uob-hep-cad/uob-hep-pc069/README.md

# uob-hep-pc069
DUNE Timing System Reference Hardware FMC. 

Successor to pc053a,c,d,e ( https://webapps-pp.bris.ac.uk/svn/uob-hep-pc053a/ )

Circuit schematic at https://github.com/uob-hep-cad/uob-hep-pc069/blob/main/hardware/Schematics/pc069a_toplevel.pdf

(N.B. Unlike pc053 , this design has no ADN2814 CDR )

List of changes w.r.t. pc053e at https://uob-my.sharepoint.com/:x:/g/personal/phdgc_bristol_ac_uk/Eb3lEkg4T_dNv52CUFCi3MEB-VoL37d42aNxBQbhaa6lCw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 (sorry, UoB only :-( )

Top level IPBus-Build (ipbb) dependency file for a design to act as a timing master when used in conjunction with a Digilent Nexys Video FPGA board can be found at https://gitlab.cern.ch/dune-daq/timing/dune-timing-firmware/-/blob/develop/projects/master/firmware/cfg/top_digilent_nexys_video_a200_pc069a.dep

Ready-built FPGA configuration file at https://pdts-fw.web.cern.ch/pdts-fw/index.php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

Can use dtsbutler to control master design. 

See https://github.com/DUNE-DAQ/timing/wiki/Dune-Timing-System-Page-1 


*Top view of pc069a*


*Bottom view of pc069a*

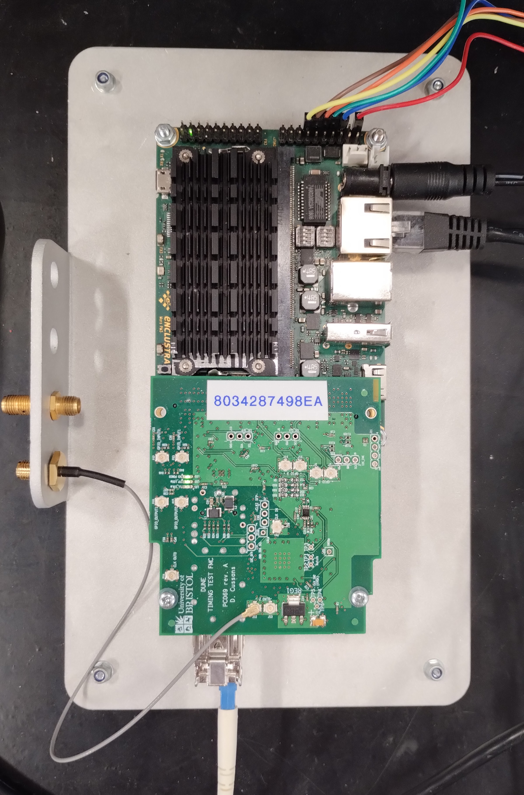
[picture p1: images/pc069a_on_pm3_IMG_20240729_135957526.jpg]

*pc069a mounted on Enclustra PM3/AX3 FPGA board*
