uob-hep-cad/uob-hep-pc069/hardware/Manufacturing/artwork/pc069c_25-manufacturing-artwork-2025-02-06/pc069c_summary_bom_mouser.xlsx

TITLE: Bill of Materials
DATE: 01/31/2025
DESIGN: pc069c_toplevel
TEMPLATE: Z:\cad\tools\cadence_templates\spreadsheet-format.bom
CALLOUT:
Part Name | Ref Des | Qty | PART_NUMBER | Do Not Fit | Mouser Part Number | Mfr Part Number | Manufacturer Name | Description
24AA025E48T-I/SN | IC2 | 1 | 24AA025E48T-I/SN | ? | 579-24AA025E48T-I/SN | 24AA025E48T-I/SN | Microchip
74LCX04MTC | IC9 | 1 | 74LCX04MTC | ? | 512-74LCX04MTC | 74LCX04MTC | onsemi | Inverters Inverters Hex Inverter
ADCMP604BKSZ | IC6,IC7 | 2 | ADCMP604BKSZ | ? | 584-ADCMP604BKSZR7 | ADCMP604BKSZ-REEL7 | Analog Devices Inc. | Analog Comparators Analog Comparators Rail to rail,sing chan, TTL/CMOS Compara
Capacitor, SMD, 0402 , 1.0NF,50V | C30,C34,C37,C41 | 4 | Capacitor , SMD , 0402_1NF_50V_10% | ? |  |  | Newbury Electronics
Capacitor, SMD, 0402 , 100NF,16V | C1,C2,C3,C4,C5,C6,C7,C8,C9,C10,C11,C13,C14,C15,C16,C17,C18,C19,C20,C21,C22,C23,C24,C25,C26,C27,C28,C29,C31,C32,C33,C36,C38,C39,C40,C42,C43,C44,C45,C46,C47,C48,C49,C50,C52,C53,C55,C56,C57,C58,C59,C60,C61,C62,C63,C69,C70,C71,C72,C107,C117 | 61 | Capacitor , SMD , 0402_100NF_16V_10% | ? |  |  | Newbury Electronics
Capacitor, SMD, 0805 , 10UF,16V | C35,C51,C54,C64,C65,C66 | 6 | Capacitor , SMD , 0805_10UF_16V_10% | ? |  |  | Newbury Electronics
CON20P_SFP-1888247-1 | J4 | 1 | 1888247-1 | ? | 571-1888247-1 | 1888247-1 | TE Connectivity | I/O Connectors I/O Connectors 20 POS SMT 30um GOLD HIGH SPEED
CON3P-MTLW-103-07-L-S-250 | J3,J5,J6,J8,J10 | 5 | MTLW-103-07-L-S-250 | TRUE | 200-MTLW10307LS250 | MTLW-103-07-L-S-250 | Samtec | Headers & Wire Housings Headers & Wire Housings .100" Low Profile Variable Post Height Terminal Strip
CON400P_40ABCDEFGHJK-SEAM-40-03.5-S-10-2-A-K-TR | P1 | 1 | SEAM-40-03.5-S-10-2-A-K-TR | ? | 200-SEAM4003.5S102AK | SEAM-40-03.5-S-10-2-A-K-TR | Samtec | Board to Board & Mezzanine Connectors Board to Board & Mezzanine Connectors .050" SEARAY High-Speed High-Density Open-Pin-Field Array Terminal
CON4P-MTLW-104-07-L-S-250 | J11 | 1 | MTLW-104-07-L-S-250 | TRUE | 200-MTLW10407LS250 | MTLW-104-07-L-S-250 | Samtec | Headers & Wire Housings Headers & Wire Housings .100" Low Profile Variable Post Height Terminal Strip
DS90LV028A_SOIC | IC8 | 1 | DS90LV028ATM | ? | 926-DS90LV028ATMNOPB | DS90LV028ATM/NOPB | Texas Instruments | LVDS Interface IC 3V LVDS DUAL CMOS DIFF LINE RECEIVER
ELCAPTAN_SMD-22UF,10V | C12 | 1 | T491A226K010A | ? | 80-T491A226K010AH | T491A226K010AH | KEMET | Tantalum Capacitors - Solid SMD Tantalum Capacitors - Solid SMD 10v 22uF 1206 10% ESR=6ohms
INDUCTANCE_LQH32C_23-4.7UH | L1,L2 | 2 | LQH32CN4R7M23 | ? | 81-LQH32CN4R7M23L | LQH32CN4R7M23L | Murata | RF Inductors - SMD RF Inductors - SMD 4.7 UH 20%
LD3985M25R | RG1,RG2 | 2 | LD3985M25R | ? | 511-LD3985M25R | LD3985M25R | STMicroelectronics | LDO Voltage Regulators LDO Voltage Regulators 2.5V 0.15A Ultra Low
LGL29K-G2J1-24 | LD1,LD2,LD3 | 3 | LGL29K-G2J1-24 | ? | 720-LGL29KG2J124Z | LG L29K-G2J1-24 | ams OSRAM | Single Color LEDs Single Color LEDs Green, 570nm 12mcd, 2mA
LM1117-MPX-1.8 | REG1 | 1 | LM1117MPX-1.8 | ? | 926-LM1117MPX-18 | LM1117MPX-1.8 | Texas Instruments | LDO Voltage Regulators LDO Voltage Regulators
MAX9381ESA_SMD-MAX9381ESA | U1 | 1 | MAX9381ESA | ? | 700-MAX9381ESA | MAX9381ESA+ | Analog Devices Inc. | Flip Flops Flip Flops Lowest Power 3.0GHz ECL/PECL Differentia
PCOAX-U.FL-R-SMT-1(10) | J2,J7,J12,J13,J14,J15,PX1,PX2,PX3,PX4,PX5,PX6 | 12 | U.FL-R-SMT-1(10) | ? | 798-U.FL-R-SMT-110 | U.FL-R-SMT-1(10) | Hirose Electric | RF Connectors / Coaxial Connectors RF Connectors / Coaxial Connectors SMT ML REC AU 50 OHM W/ANTI SLDR WCKNG R
Resistor, SMD, 0402 , 0.0625W-XX,1% | R9,R14,R32,R33,R41,R60,R140,R411 | 8 | Resistor , SMD , 0402_XX_1%_0.063W | TRUE | ? | ? | Newbury Electronics | ? | GENERIC | ?
Resistor, SMD, 0402 0R0,1% | R44,R58,R59 | 3 | Resistor , SMD , 0402_00R | ? | ? | ? | Newbury Electronics | ? | GENERIC | ?
Resistor, SMD, 0402 100,1% | R7,R8,R11,R18,R45,R46 | 6 | Resistor , SMD , 0402_100R | ? | ? | ? | Newbury Electronics | ? | GENERIC | ?
Resistor, SMD, 0402 150,1% | R5,R6 | 2 | Resistor , SMD , 0402_150R | ? | ? | ? | Newbury Electronics | ? | GENERIC | ?
Resistor, SMD, 0402 1K,1% | R10,R17,R19,R20,R21 | 5 | Resistor , SMD , 0402_1K | ? | ? | ? | Newbury Electronics | ? | GENERIC | ?
Resistor, SMD, 0402 2K,1% | R36,R38 | 2 | Resistor , SMD , 0402_2K | ? | ? | ? | Newbury Electronics | ? | GENERIC | ?
Resistor, SMD, 0402 3.0K,1% | R35,R37 | 2 | Resistor , SMD , 0402_3K0 | ? | ? | ? | Newbury Electronics | ? | GENERIC | ?
Resistor, SMD, 0402 4.7K,1% | R1,R13,R16,R22,R23,R24,R25,R28,R29,R39,R42,R43,R61,R103,R138,R142,R143,R242,R1328 | 19 | Resistor , SMD , 0402_4K7 | ? | ? | ? | Newbury Electronics | ? | GENERIC | ?
Resistor, SMD, 0402 750,1% | R50,R51,R56 | 3 | Resistor , SMD , 0402_750R | ? | ? | ? | Newbury Electronics | ? | GENERIC | ?
Resistor, SMD, 0603 , 1.2K,1% | R12,R52,R54,R57 | 4 | Resistor , SMD , 0603_1K2 | ? | ? | ? | Newbury Electronics | ? | GENERIC | ?
Resistor, SMD, 0603 , 100,1% | R2,R3,R15,R26,R30,R31,R40,R62 | 8 | Resistor , SMD , 0603_100R | ? | ? | ? | Newbury Electronics | ? | GENERIC | ?
Resistor, SMD, 0603 , 33,1% | R27,R47,R48,R49 | 4 | Resistor , SMD , 0603_33R | ? | ? | ? | Newbury Electronics | ? | GENERIC | ?
Resistor, SMD, 0603 , 820,1% | R4,R34,R53,R55 | 4 | Resistor , SMD , 0603_820R | ? | ? | ? | Newbury Electronics | ? | GENERIC | ?
SFP_CAGE-SP-74737-004 | SFP1 | 1 | 74737-004 | ? | 538-74737-0041 | 74737-0041 | Molex | I/O Connectors I/O Connectors SFP 1x Cage PressFit 3.05 Legs SS 301
SI5395A-A-GM | IC3 | 1 | SI5395A-A-GM | ? | 634-SI5395A-A-GM | SI5395A-A-GM | Skyworks | Clock Synthesizer / Jitter Cleaner Clock Synthesizer / Jitter Cleaner Single PLL jitter attenuator with ext crystal: 12-outputs up to 1028 MHz; integer+fractional
SIT5021AI-2DE-25E-50.000000 | QZ1 | 1 | SIT5021AI-2DE-25E-50.000000X | ? | 788-1AI-2DE-5E-50X | SIT5021AI-2DE-25E-50.000000X | SiTime | TCXO Oscillators TCXO Oscillators 50MHz 2.5V 5ppm -40C +85C
SN74AVC4T245PW | IC10 | 1 | SN74AVC4T245PW | ? | 595-SN74AVC4T245PW | SN74AVC4T245PW | Texas Instruments | Translation - Voltage Levels Translation - Voltage Levels 4-Bit Dual-Supply Bu s Xcvr A 595-SN74AVC4T245PWT
SN74LVC2GU04DCK | IC18 | 1 | SN74LVC2GU04DCK | ? | 595-SN74LVC2GU04DCKR | SN74LVC2GU04DCKR | Texas Instruments | Inverters Inverters Dual. A 595-SN74LVC2GU04DCKT
SY58608UMG | IC4 | 1 | SY58608UMG | ? | 998-SY58608UMG | SY58608UMG | Microchip | Encoders, Decoders, Multiplexers & Demultiplexers Encoders, Decoders, Multiplexers & Demultiplexers 4.25Gbps 2:1 LVPECL Multiplexer w/ FSI Inputs
TCA9800DGK | IC1,IC15 | 2 | TCA9800DGK | ? | 595-TCA9800DGKR | TCA9800DGKR | Texas Instruments | Interface - Signal Buffers, Repeaters Interface - Signal Buffers, Repeaters 2-bit level-translat ing 400-kHz I2C/SMBu A 595-TCA9800DGKT
TMP1075NDRLR-TEXAS INSTRUMENTS,TMP1075NDRLR | IC11 | 1 | TMP1075NDRLR | ? | 595-TMP1075NDRLR | TMP1075NDRLR | Texas Instruments
TP_HOLE-0.5MM | TP1,TP2,TP3,TP4,TP5,TP6 | 6 | TP_HOLE_0.5mm | TRUE
TP_HOLE-0.8MM | TP9,TP10 | 2 | TP_HOLE_0.8mm | TRUE
TOTAL |  | 193
