uob-hep-cad/uob-hep-pc069/hardware/Manufacturing/artwork/pc069b-manufacturing-artwork-2023-08-23/pc069b_summary_bom.xlsx

TITLE: Bill of Materials
DATE: 08/22/2023
DESIGN: pc069b_toplevel
TEMPLATE: /projects/HEP_Instrumentation/cad/tools/cadence_templates/spreadsheet-format.bom
CALLOUT:
Part Name | Ref Des | Quantity | Manufacturer PART NUMBER | Supplier | Do Not Fit | MANUFACTURER | DNF
24AA025E48T-I/SN | IC2 | 1 | 24AA025E48T-I/SN | FREE-ISSUE | ? | MICROCHIP | ?
74LCX04MTC | IC9 | 1 | 74LCX04MTC |  | ? | FAIRCHILD SEMICONDUCTOR | ?
ADCMP604BKSZ | IC6,IC7 | 2 | ADCMP604BKSZ |  | ? | ANALOG DEVICES | ?
CAPCERSMDCL2_0402-1.0NF,50V_GEN | C30,C34,C37,C41 | 4 | CC0402_1NF_50V_10%_X7R |  | ? | GENERIC | ?
CAPCERSMDCL2_0402-100NF,16V_GEN | C1,C2,C3,C4,C5,C6,C7,C8,C9,C10,C11,C13,C14,C15,C16,C17,C18,C19,C20,C21,C22,C23,C24,C25,C26,C27,C28,C29,C31,C32,C33,C36,C38,C39,C40,C45,C46,C47,C48,C49,C52,C53,C55,C56,C57,C58,C59,C60,C61,C62,C63,C69,C70,C71,C72,C107,C117 | 57 | CC0402_100NF_16V_10%_X7R |  | ? | GENERIC | ?
CAPCERSMDCL2_0603-100NF,16V | C42 | 1 | CC0603_100NF_16V_10%_X7R |  | ? | GENERIC | ?
CAPCERSMDCL2_0603-10UF_X5R,6.3V | C64 | 1 | CC0603_10UF_6V3_10%_X5R |  | ? | GENERIC | ?
CAPCERSMDCL2_0805-10UF,16V | C35 | 1 | C0805C106K4PAC |  | ? | KEMET | ?
CON20P_SFP-1888247-1 | J4 | 1 | 1888247-1 |  | ? | TYCO | ?
CON3P-MTLW-103-07-L-S-250 | J3,J5,J6,J8,J10 | 5 | MTLW-103-07-L-S-250 |  | TRUE | SAMTEC | ?
CON400P_40ABCDEFGHJK-SEAM-40-03.5-S-10-2-A-K-TR | P1 | 1 | SEAM-40-03.5-S-10-2-A-K-TR |  | ? | SAMTEC | ?
CON4P-MTLW-104-07-L-S-250 | J11 | 1 | MTLW-104-07-L-S-250 |  | TRUE | SAMTEC | ?
DS90LV028A_SOIC | IC8 | 1 | 08.DS90LV028ATM |  | ? | NATIONAL SEMICONDUCTOR | ?
CAP Tantalum SMD 22UF 10V | C12 | 1 | T491A226K010A |  | ? | KEMET | ?
FERRITE_SMD-BLM18AG102SN1,MURATA | L3 | 1 | BLM18AG102SN1 |  | ? | MURATA | ?
INDUCTANCE_LQH32C_23-4.7UH | L1,L2 | 2 | LQH32CN4R7M23 |  | ? | MURATA | ?
LGL29K-G2J1-24 | LD1,LD2,LD3 | 3 | LGL29K-G2J1-24 |  | ? | OSRAM | ?
LM1117-MPX-1.8 | REG1 | 1 | LM1117MPX-1.8 |  | ? | NATIONAL SEMICONDUCTOR | ?
MAX9381ESA_SMD-MAX9381ESA | U1 | 1 | MAX9381ESA |  | ? | ? | ?
PCA9306DCU | IC1 | 1 | PCA9306DCU |  | ? | TEXAS INSTRUMENTS | ?
PCA9517DGKR | IC15 | 1 | PCA9517DGKR |  | ? | TEXAS INSTRUMENTS | ?
PCOAX-U.FL-R-SMT-1(10) | J2,J7,J12,J13,J14,J15,PX1,PX2,PX3,PX4,PX5,PX6 | 12 | U.FL-R-SMT-1(10) |  | ? | HIROSE | ?
RES 0402 SMD 0.0625W XX 1% | R60 | 1 | R0402_XX_1%_0.063W |  | TRUE | GENERIC | ?
RES 0402 SMD 1/16W 0R0 1% | R58,R59 | 2 | R0402_0R0_1%_0.063W_100PPM |  | ? | GENERIC | ?
RES 0402 SMD 1/16W 100 1% | R7,R8,R11,R18 | 4 | R0402_100R_1%_0.063W_200PPM |  | ? | GENERIC | ?
RES 0402 SMD 1/16W 150 1% | R5,R6 | 2 | R0402_150R_1%_0.063W_200PPM |  | ? | GENERIC | ?
RES 0402 SMD 1/16W 1K 1% | R10,R17,R19,R20,R21 | 5 | R0402_1K_1%_0.063W_100PPM |  | ? | GENERIC | ?
RES 0402 SMD 1/16W 200K 1% | R1 | 1 | R0402_200K_1%_0.063W_200PPM |  | ? | GENERIC | ?
RES 0402 SMD 1/16W 2K 1% | R36,R38 | 2 | R0402_2K_1%_0.063W_100PPM |  | ? | GENERIC | ?
RES 0402 SMD 1/16W 3.0K 1% | R35,R37 | 2 | R0402_3K0_1%_0.063W_200PPM |  | ? | GENERIC | ?
RES 0402 SMD 1/16W 33 1% | R26 | 1 | R0402_33R_1%_0.063W_200PPM |  | ? | GENERIC | ?
RES 0402 SMD 1/16W 4.7K 1% | R13,R16,R22,R23,R24,R25,R28,R29,R39,R40,R41,R42,R43,R61,R103,R138,R140,R142,R143,R242,R411,R1328 | 22 | R0402_4K7_1%_0.063W_200PPM |  | ? | GENERIC | ?
RES 0402 SMD 1/16W 51 1% | R45,R46 | 2 | R0402_51R_1%_0.063W_200PPM |  | ? | GENERIC | ?
RES 0402 SMD 1/16W 750 1% | R50,R51,R56 | 3 | R0402_750R_1%_0.063W_200PPM |  | ? | GENERIC | ?
RES 0603 SMD 1/10W 100 1% | R2,R3 | 2 | R0603_100R_1%_0.1W_100PPM |  | ? | GENERIC | ?
RES 0603 SMD 1/10W 200 1% | R12,R52,R54,R57 | 4 | R0603_200R_1%_0.1W_100PPM |  | ? | GENERIC | ?
RES 0603 SMD 1/10W 33 1% | R47,R48,R49 | 3 | R0603_33R_1%_0.1W_100PPM |  | ? | GENERIC | ?
RES 0603 SMD 1/10W 51 1% | R27,R30,R31 | 3 | R0603_51R_1%_0.1W_100PPM |  | ? | GENERIC | ?
RES 0603 SMD 1/10W 825 1% | R4,R34,R53,R55 | 4 | R0603_825R_1%_0.1W_100PPM |  | ? | GENERIC | ?
SFP_CAGE-SP-74737-004 | SFP1 | 1 | 74737-004 |  | ? | MOLEX | ?
SI5345A-D-GM | IC3 | 1 | Si5345A-D-GM |  | ? | Skyworks | ?
SIT5021AI-2DE-25E-50.000000 | QZ1 | 1 | SIT5021AI-2DE-25E-50.000000 |  | ? | SI TIME | ?
SN74AVC4T245PW | IC10 | 1 | SN74AVC4T245PW |  | ? | TEXAS INSTRUMENTS | ?
SN74LVC2GU04DCK | IC18 | 1 | SN74LVC2GU04DCK |  | ? | TEXAS INSTRUMENTS | ?
SY58608UMG | IC4 | 1 | SY58608UMG |  | ? | MICREL | ?
TMP1075NDRLR-TEXAS INSTRUMENTS,TMP1075NDRLR | IC11 | 1 | ? |  | ? | ? | ?
TP_HOLE-0.5MM | TP1,TP2,TP3,TP4,TP5,TP6 | 6 | TP_HOLE_0.5mm |  | TRUE | ? | ?
TP_HOLE-0.8MM | TP9,TP10 | 2 | TP_HOLE_0.8mm |  | TRUE | ? | ?
TOTAL |  | 178
