uob-hep-cad/uob-hep-pc069/hardware/Cadence/worklib/pc069b_toplevel/physical/jt3_drawing.dxf

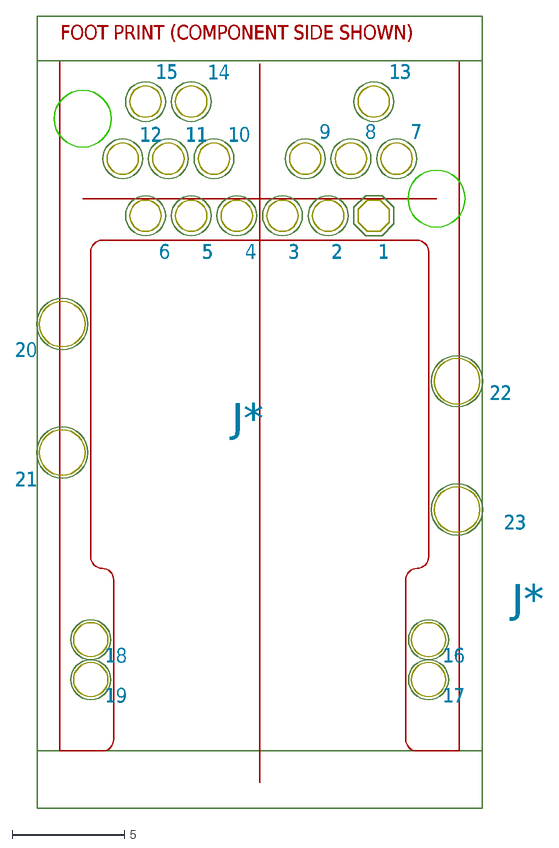
[picture p2: CAD file, 2023-09-11]
hardware/Cadence/worklib/pc069b_toplevel/physical/jt3_drawing.dxf
23
22
21
20
19
18
17
16
15
14
13
6
5
4
3
7
8
9
2
10
11
12
1
J*
FOOT PRINT (COMPONENT SIDE SHOWN)
