uob-hep-cad/uob-hep-pc069/hardware/Cadence/worklib/pc069c_toplevel/physical/3DModel/SingleWidthFMC.stp

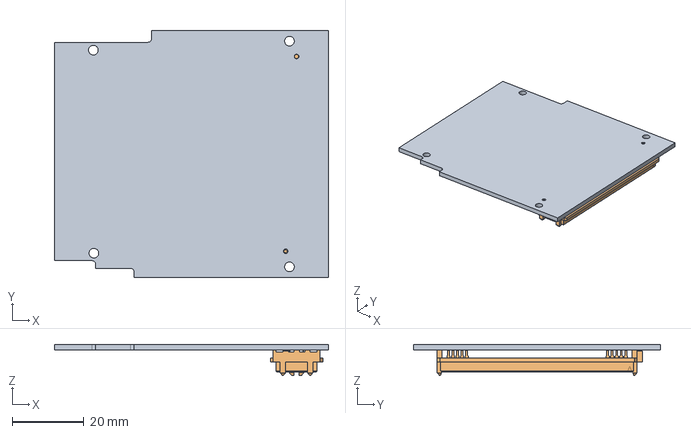
[picture p3: CAD file, 2023-09-11]
hardware/Cadence/worklib/pc069c_toplevel/physical/3DModel/SingleWidthFMC.stp
76.5 x 69.0 x 8.73 mm
BOARD_OUTLINE
