uob-hep-cad/uob-hep-pc069/(list of files, cad)

Other CAD files:
hardware/Cadence/worklib/pc069c_toplevel/physical/3DModel/459704305.ipt
hardware/Cadence/worklib/pc069c_toplevel/physical/3DModel/471510002.ipt
hardware/Cadence/worklib/pc069c_toplevel/physical/3DModel/747370004.ipt
hardware/Cadence/worklib/pc069c_toplevel/physical/3DModel/A3F1807F-1856-4851-85FF-7D796C268A47.ipt
hardware/Cadence/worklib/pc069c_toplevel/physical/3DModel/BOARD_OUTLINE.ipt
hardware/Cadence/worklib/pc069c_toplevel/physical/3DModel/C-1888247-1.ipt
hardware/Cadence/worklib/pc069c_toplevel/physical/3DModel/C0402.iam
hardware/Cadence/worklib/pc069c_toplevel/physical/3DModel/C0603.iam
hardware/Cadence/worklib/pc069c_toplevel/physical/3DModel/C0805.iam
hardware/Cadence/worklib/pc069c_toplevel/physical/3DModel/COMPONENTS.iam
hardware/Cadence/worklib/pc069c_toplevel/physical/3DModel/CircuitWorks-TEST POINT.ipt
hardware/Cadence/worklib/pc069c_toplevel/physical/3DModel/HIROSE_U-FL-R-SMT-1_10.iam
hardware/Cadence/worklib/pc069c_toplevel/physical/3DModel/INDC3225X220N.iam
hardware/Cadence/worklib/pc069c_toplevel/physical/3DModel/LEDC1708X65N.iam
hardware/Cadence/worklib/pc069c_toplevel/physical/3DModel/LOCATING.iam
hardware/Cadence/worklib/pc069c_toplevel/physical/3DModel/M3_spacer_5mm.ipt
hardware/Cadence/worklib/pc069c_toplevel/physical/3DModel/MOLEX_74737004.iam
hardware/Cadence/worklib/pc069c_toplevel/physical/3DModel/MTLW-103-07-L-S-250.iam
hardware/Cadence/worklib/pc069c_toplevel/physical/3DModel/MTLW-104-07-L-S-250.iam
hardware/Cadence/worklib/pc069c_toplevel/physical/3DModel/OSCSC105P250X320X180-6N.iam
hardware/Cadence/worklib/pc069c_toplevel/physical/3DModel/OldVersions/BOARD_OUTLINE.0001.ipt
hardware/Cadence/worklib/pc069c_toplevel/physical/3DModel/OldVersions/COMPONENTS.0001.iam
hardware/Cadence/worklib/pc069c_toplevel/physical/3DModel/OldVersions/SAMTEC_SEAM-40-035-S-10-2-A.0001.iam
hardware/Cadence/worklib/pc069c_toplevel/physical/3DModel/OldVersions/pc053c_toplevel_61.0001.iam
hardware/Cadence/worklib/pc069c_toplevel/physical/3DModel/QFN50P300X300X100-17N-S185.iam
hardware/Cadence/worklib/pc069c_toplevel/physical/3DModel/QFN50P300X300X90-17N-S160.iam
hardware/Cadence/worklib/pc069c_toplevel/physical/3DModel/QFN50P500X500X100-33N-S325.iam
hardware/Cadence/worklib/pc069c_toplevel/physical/3DModel/QFN50P700X700X90-45N-S530.iam
hardware/Cadence/worklib/pc069c_toplevel/physical/3DModel/SAMTEC_HDMI-19-01-X-SM.iam
hardware/Cadence/worklib/pc069c_toplevel/physical/3DModel/SAMTEC_MTLW-103-07-L-S-250.iam
hardware/Cadence/worklib/pc069c_toplevel/physical/3DModel/SAMTEC_MTLW-104-07-L-S-250.iam
hardware/Cadence/worklib/pc069c_toplevel/physical/3DModel/SAMTEC_SEAM-40-035-S-10-2-A.iam
hardware/Cadence/worklib/pc069c_toplevel/physical/3DModel/SC70_6L.iam
hardware/Cadence/worklib/pc069c_toplevel/physical/3DModel/SOIC127P600X175-8N.iam
hardware/Cadence/worklib/pc069c_toplevel/physical/3DModel/SOIC8S_127.iam
hardware/Cadence/worklib/pc069c_toplevel/physical/3DModel/SOP50P310X90-8N.iam
hardware/Cadence/worklib/pc069c_toplevel/physical/3DModel/SOP65P210X110-6N.iam
hardware/Cadence/worklib/pc069c_toplevel/physical/3DModel/SOP65P490X110-8N.iam
hardware/Cadence/worklib/pc069c_toplevel/physical/3DModel/SOT95P280X110-5N.iam
hardware/Cadence/worklib/pc069c_toplevel/physical/3DModel/SOT95P280X145-6N.iam
hardware/Cadence/worklib/pc069c_toplevel/physical/3DModel/SW3dPS-SC70-6.ipt
hardware/Cadence/worklib/pc069c_toplevel/physical/3DModel/SingleWidthFMC.iam
hardware/Cadence/worklib/pc069c_toplevel/physical/3DModel/TP_HOLE_08.iam
hardware/Cadence/worklib/pc069c_toplevel/physical/3DModel/TSSOP14MA_065.iam
hardware/Cadence/worklib/pc069c_toplevel/physical/3DModel/TSSOP16MA_065.iam
hardware/Cadence/worklib/pc069c_toplevel/physical/3DModel/TYCO_1888247-1.iam
hardware/Cadence/worklib/pc069c_toplevel/physical/3DModel/U.FL-R-SMT-1.ipt
hardware/Cadence/worklib/pc069c_toplevel/physical/3DModel/User Library-DFN-6 3.2x2.5.iam
hardware/Cadence/worklib/pc069c_toplevel/physical/3DModel/User Library-DFN-6 3.2x2.5_0.7x0.5 pin.ipt
hardware/Cadence/worklib/pc069c_toplevel/physical/3DModel/User Library-DFN-6 3.2x2.5_0.9x0.7 pin.ipt
hardware/Cadence/worklib/pc069c_toplevel/physical/3DModel/User Library-DFN-6 3.2x2.5_Body.ipt
hardware/Cadence/worklib/pc069c_toplevel/physical/3DModel/User Library-LED_0603_WS.iam
hardware/Cadence/worklib/pc069c_toplevel/physical/3DModel/User Library-LED_0603_WS_Fillet.ipt
hardware/Cadence/worklib/pc069c_toplevel/physical/3DModel/User Library-LED_0603_WS_Pad.ipt
hardware/Cadence/worklib/pc069c_toplevel/physical/3DModel/User Library-LED_0603_WS_Pad004.ipt
hardware/Cadence/worklib/pc069c_toplevel/physical/3DModel/User Library-LED_0603_WS_Pocket001.ipt
hardware/Cadence/worklib/pc069c_toplevel/physical/3DModel/User Library-LQH32CN.ipt
hardware/Cadence/worklib/pc069c_toplevel/physical/3DModel/User Library-MO-193E.ipt
hardware/Cadence/worklib/pc069c_toplevel/physical/3DModel/User Library-QFN-16.ipt
hardware/Cadence/worklib/pc069c_toplevel/physical/3DModel/User Library-QFN32-1.ipt
hardware/Cadence/worklib/pc069c_toplevel/physical/3DModel/User Library-RESC1608X05N.ipt
hardware/Cadence/worklib/pc069c_toplevel/physical/3DModel/User Library-RES_1005-0402.ipt
hardware/Cadence/worklib/pc069c_toplevel/physical/3DModel/User Library-SOIC-8-1.ipt
hardware/Cadence/worklib/pc069c_toplevel/physical/3DModel/User Library-SOIC8_4_9x3_9_1_53_p1_27.ipt
hardware/Cadence/worklib/pc069c_toplevel/physical/3DModel/User Library-SOP50P310X90-8N[8US8_VSSOP_DCU_MO-187CA].ipt
hardware/Cadence/worklib/pc069c_toplevel/physical/3DModel/User Library-TSSOP.ipt
hardware/Cadence/worklib/pc069c_toplevel/physical/3DModel/User Library-TSSOP_1.ipt
hardware/Cadence/worklib/pc069c_toplevel/physical/3DModel/User Library-smd_qfn-44.ipt
hardware/Cadence/worklib/pc069c_toplevel/physical/3DModel/User Library-sot363.ipt
hardware/Cadence/worklib/pc069c_toplevel/physical/3DModel/_MTLW-03-07-S-250.ipt
hardware/Cadence/worklib/pc069c_toplevel/physical/3DModel/_MTLW-04-07-S-250.ipt
hardware/Cadence/worklib/pc069c_toplevel/physical/3DModel/_MTLW-103-07-L-S-250_body.ipt
hardware/Cadence/worklib/pc069c_toplevel/physical/3DModel/_MTLW-104-07-L-S-250_body.ipt
hardware/Cadence/worklib/pc069c_toplevel/physical/3DModel/fmc_mezzanine.iam
hardware/Cadence/worklib/pc069c_toplevel/physical/3DModel/led_0603.iam
hardware/Cadence/worklib/pc069c_toplevel/physical/3DModel/pc053c_toplevel_61.iam
hardware/Cadence/worklib/pc069c_toplevel/physical/OldVersions/446611011.0001.ipt
hardware/Cadence/worklib/pc069c_toplevel/physical/OldVersions/459704305.0001.ipt
hardware/Cadence/worklib/pc069c_toplevel/physical/OldVersions/747370004.0001.ipt
hardware/Cadence/worklib/pc069c_toplevel/physical/OldVersions/A3F1807F-1856-4851-85FF-7D796C268A47.0001.ipt
hardware/Cadence/worklib/pc069c_toplevel/physical/OldVersions/C-1888247-1.0001.ipt
hardware/Cadence/worklib/pc069c_toplevel/physical/OldVersions/C0402.0001.iam
hardware/Cadence/worklib/pc069c_toplevel/physical/OldVersions/C0603.0001.iam
hardware/Cadence/worklib/pc069c_toplevel/physical/OldVersions/C0805.0001.iam
hardware/Cadence/worklib/pc069c_toplevel/physical/OldVersions/COMPONENTS.0001.iam
hardware/Cadence/worklib/pc069c_toplevel/physical/OldVersions/CircuitWorks-TEST POINT.0001.ipt
hardware/Cadence/worklib/pc069c_toplevel/physical/OldVersions/HIROSE_U-FL-R-SMT-1_10.0001.iam
hardware/Cadence/worklib/pc069c_toplevel/physical/OldVersions/INDC3225X220N.0001.iam
hardware/Cadence/worklib/pc069c_toplevel/physical/OldVersions/LEDC1708X65N.0001.iam
hardware/Cadence/worklib/pc069c_toplevel/physical/OldVersions/MOLEX_44661-1011.0001.iam
hardware/Cadence/worklib/pc069c_toplevel/physical/OldVersions/MOLEX_74737004.0001.iam
hardware/Cadence/worklib/pc069c_toplevel/physical/OldVersions/MTLW-103-07-L-S-250.0001.iam
hardware/Cadence/worklib/pc069c_toplevel/physical/OldVersions/MTLW-103-07-L-S-250.0002.iam
hardware/Cadence/worklib/pc069c_toplevel/physical/OldVersions/OSCSC105P250X320X180-6N.0001.iam
hardware/Cadence/worklib/pc069c_toplevel/physical/OldVersions/QFN50P300X300X100-17N-S185.0001.iam
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
