uob-hep-cad/uob-hep-pc069/hardware/Manufacturing/artwork/pc069c_23-manufacturing-artwork-2025-01-31/placement_pin1.txt

VERSION = 2.0
UUNITS = MILLIMETERS

#    refdes          !   symbol_x !   symbol_y ! rotation ! mirror ! symbol_name                      ! embedded_layer                  
#-----------------------------------------------------------------------------------------------------------------------
C35                  !   -51.9000 !    35.3000 !      180 !      m ! C0805                            !                                 
C64                  !   -25.6000 !    47.2000 !      180 !        ! C0805                            !                                 
C51                  !   -34.8000 !     6.1000 !      270 !      m ! C0805                            !                                 
C54                  !   -44.0000 !     6.1000 !      270 !      m ! C0805                            !                                 
C65                  !   -19.0000 !    37.5000 !        0 !        ! C0805                            !                                 
C66                  !   -19.0000 !    40.5000 !        0 !        ! C0805                            !                                 
RG1                  !   -37.8000 !     7.9500 !        0 !      m ! SOT95P280X145-5N                 !                                 
RG2                  !   -17.0500 !    37.7000 !      270 !      m ! SOT95P280X145-5N                 !                                 
IC4                  !   -19.5500 !    44.0500 !      180 !      m ! QFN50P300X300X90-17N-S160        !                                 
IC1                  !   -27.4500 !    18.6750 !      180 !        ! SOP65P490X110-8N                 !                                 
IC15                 !   -10.9850 !    33.8130 !        0 !      m ! SOP65P490X110-8N                 !                                 
R12                  !   -20.1000 !    22.1500 !       90 !        ! C0603                            !                                 
R52                  !   -23.1000 !    22.1500 !       90 !        ! C0603                            !                                 
R54                  !   -21.6000 !    22.1500 !       90 !        ! C0603                            !                                 
R57                  !   -24.6000 !    22.1500 !       90 !        ! C0603                            !                                 
R4                   !   -20.1000 !    25.7500 !       90 !        ! C0603                            !                                 
R34                  !   -23.1000 !    25.7500 !       90 !        ! C0603                            !                                 
R53                  !   -21.6000 !    25.7500 !       90 !        ! C0603                            !                                 
R55                  !   -24.6000 !    25.7500 !       90 !        ! C0603                            !                                 
R27                  !   -33.2500 !    24.8000 !      180 !        ! C0603                            !                                 
R30                  !   -10.1000 !    60.3000 !       90 !        ! C0603                            !                                 
R31                  !   -10.1000 !    54.5500 !       90 !        ! C0603                            !                                 
QZ1                  !   -52.9400 !    13.7000 !       90 !      m ! OSCSC254P500X700X100-6N          !                                 
IC11                 !   -36.2699 !    18.0501 !        0 !      m ! SOT_DRL_TEX                      !                                 
U1                   !   -20.5000 !    27.8000 !        0 !      m ! SOIC8                            !                                 
REG1                 !   -61.1700 !    25.4974 !       90 !        ! SOT223                           !                                 
C12                  !   -61.5200 !    17.3000 !      270 !        ! C3528POL                         !                                 
TP4                  !   -55.4700 !    15.4000 !        0 !        ! TP_HOLE_05                       !                                 
TP5                  !   -55.4700 !    17.4500 !        0 !        ! TP_HOLE_05                       !                                 
TP6                  !   -57.3700 !    16.3000 !        0 !        ! TP_HOLE_05                       !                                 
TP1                  !   -43.0000 !    18.1000 !        0 !        ! TP_HOLE_05                       !                                 
TP2                  !   -45.1000 !    18.1000 !        0 !        ! TP_HOLE_05                       !                                 
TP3                  !   -39.9700 !    18.0500 !        0 !        ! TP_HOLE_05                       !                                 
R2                   !   -20.1500 !    25.8000 !        0 !      m ! C0603                            !                                 
R3                   !   -24.5500 !    25.8000 !      180 !      m ! C0603                            !                                 
IC3                  !   -40.1200 !    22.1000 !      270 !      m ! QFN50P900X900X90-65N-S530        !                                 
R40                  !   -35.0000 !    20.0500 !        0 !        ! C0402                            !                                 
R41                  !   -35.0000 !    19.0000 !        0 !        ! C0402                            !                                 
R140                 !   -18.4000 !    30.7000 !      270 !      m ! C0402                            !                                 
R411                 !   -18.4000 !    35.0000 !       90 !      m ! C0402                            !                                 
R60                  !   -21.2700 !    45.2000 !       90 !      m ! C0402                            !                                 
R58                  !   -14.8500 !    43.5000 !      180 !      m ! C0402                            !                                 
R59                  !   -14.8500 !    44.7000 !      180 !      m ! C0402                            !                                 
J11                  !   -15.3100 !    -1.1000 !        0 !        ! SAMTEC_MTLW-104-07-L-S-250       !                                 
IC18                 !   -20.7000 !    48.5000 !        0 !      m ! SC70_6L                          !                                 
J14                  !   -14.3450 !    25.7500 !      270 !        ! HIROSE_U-FL-R-SMT-1_10           !                                 
J15                  !   -14.3950 !    21.4000 !      270 !        ! HIROSE_U-FL-R-SMT-1_10           !                                 
J2                   !   -16.5950 !    16.4500 !      270 !        ! HIROSE_U-FL-R-SMT-1_10           !                                 
J7                   !   -16.6450 !    12.1500 !      270 !        ! HIROSE_U-FL-R-SMT-1_10           !                                 
J12                  !   -56.2750 !    34.7000 !      270 !        ! HIROSE_U-FL-R-SMT-1_10           !                                 
J13                  !   -56.2750 !    30.1000 !      270 !        ! HIROSE_U-FL-R-SMT-1_10           !                                 
PX1                  !   -33.9580 !    26.8300 !      180 !        ! HIROSE_U-FL-R-SMT-1_10           !                                 
PX2                  !   -11.9340 !    62.3290 !      270 !        ! HIROSE_U-FL-R-SMT-1_10           !                                 
PX3                  !   -11.9340 !    56.4790 !      270 !        ! HIROSE_U-FL-R-SMT-1_10           !                                 
PX4                  !   -46.5750 !    59.1000 !      270 !        ! HIROSE_U-FL-R-SMT-1_10           !                                 
PX5                  !   -27.9580 !    56.4960 !       90 !        ! HIROSE_U-FL-R-SMT-1_10           !                                 
PX6                  !   -27.9250 !    62.3000 !       90 !        ! HIROSE_U-FL-R-SMT-1_10           !                                 
IC9                  !   -34.0000 !    60.4000 !       90 !      m ! TSSOP14MA_065                    !                                 
IC6                  !    -7.0500 !    60.9500 !      270 !      m ! SOP65P210X110-6N                 !                                 
IC7                  !    -7.0500 !    55.1000 !      270 !      m ! SOP65P210X110-6N                 !                                 
IC8                  !   -18.4000 !    61.4000 !       90 !      m ! SOIC8S_127                       !                                 
R35                  !    -8.5500 !    64.1000 !      180 !      m ! C0402                            !                                 
R37                  !    -8.5500 !    58.2500 !      180 !      m ! C0402                            !                                 
R26                  !   -47.5000 !    33.9500 !      270 !      m ! C0402                            !                                 
R47                  !   -42.6500 !    59.1000 !        0 !      m ! C0603                            !                                 
R48                  !   -31.7500 !    56.5000 !      180 !      m ! C0603                            !                                 
R49                  !   -31.7500 !    62.3000 !      180 !      m ! C0603                            !                                 
IC10                 !   -14.3920 !    47.3150 !      270 !      m ! TSSOP16MA_065                    !                                 
R5                   !   -25.0500 !    35.4000 !      180 !      m ! C0402                            !                                 
R6                   !   -19.8500 !    35.4000 !        0 !      m ! C0402                            !                                 
R50                  !   -22.1000 !    52.1500 !       90 !      m ! C0402                            !                                 
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
L2                   !   -28.2240 !    42.4180 !        0 !        ! INDC3225X220N                    !                                 
L1                   !   -29.7180 !    48.1630 !      270 !        ! INDC3225X220N                    !
