uob-hep-cad/uob-hep-pc069/hardware/Cadence/worklib/pc069c_toplevel/physical/clockConfiguration/Si5344-RevB-053FR001-frrerun_fmc_testProject-Registers-nopreamble.txt

# Si538x/4x Registers Script
# 
# Part: Si5344
# Project File: Z:\cad\designs\uob-hep-pc053a\trunk\design_files\worklib\pc053a_toplevel\physical\clockConfiguration\Si5344-RevB-053FR001-frrerun_fmc_testProject.slabtimeproj
# Design ID: 053FR001
# Includes Pre/Post Download Control Register Writes: No
# Die Revision: A2
# Creator: ClockBuilder Pro v2.15 [2017-05-15]
# Created On: 2018-08-22 13:52:58 GMT+01:00
Address,Data
0x000B,0x68
0x0016,0x02
0x0017,0x1C
0x0018,0xFF
0x0019,0xFF
0x001A,0xFF
0x002B,0x02
0x002C,0x00
0x002D,0x00
0x002E,0x00
0x002F,0x00
0x0030,0x00
0x0031,0x00
0x0032,0x00
0x0033,0x00
0x0034,0x00
0x0035,0x00
0x0036,0x00
0x0037,0x00
0x0038,0x00
0x0039,0x00
0x003A,0x00
0x003B,0x00
0x003C,0x00
0x003D,0x00
0x003F,0x00
0x0040,0x04
0x0041,0x00
0x0042,0x00
0x0043,0x00
0x0044,0x00
0x0045,0x0C
0x0046,0x00
0x0047,0x00
0x0048,0x00
0x0049,0x00
0x004A,0x00
0x004B,0x00
0x004C,0x00
0x004D,0x00
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
