uob-hep-cad/uob-hep-pc069/hardware/Schematics/pc069c_toplevel_5feb25.pdf

## SFP I2C ADDRESSES: 1010000 AND

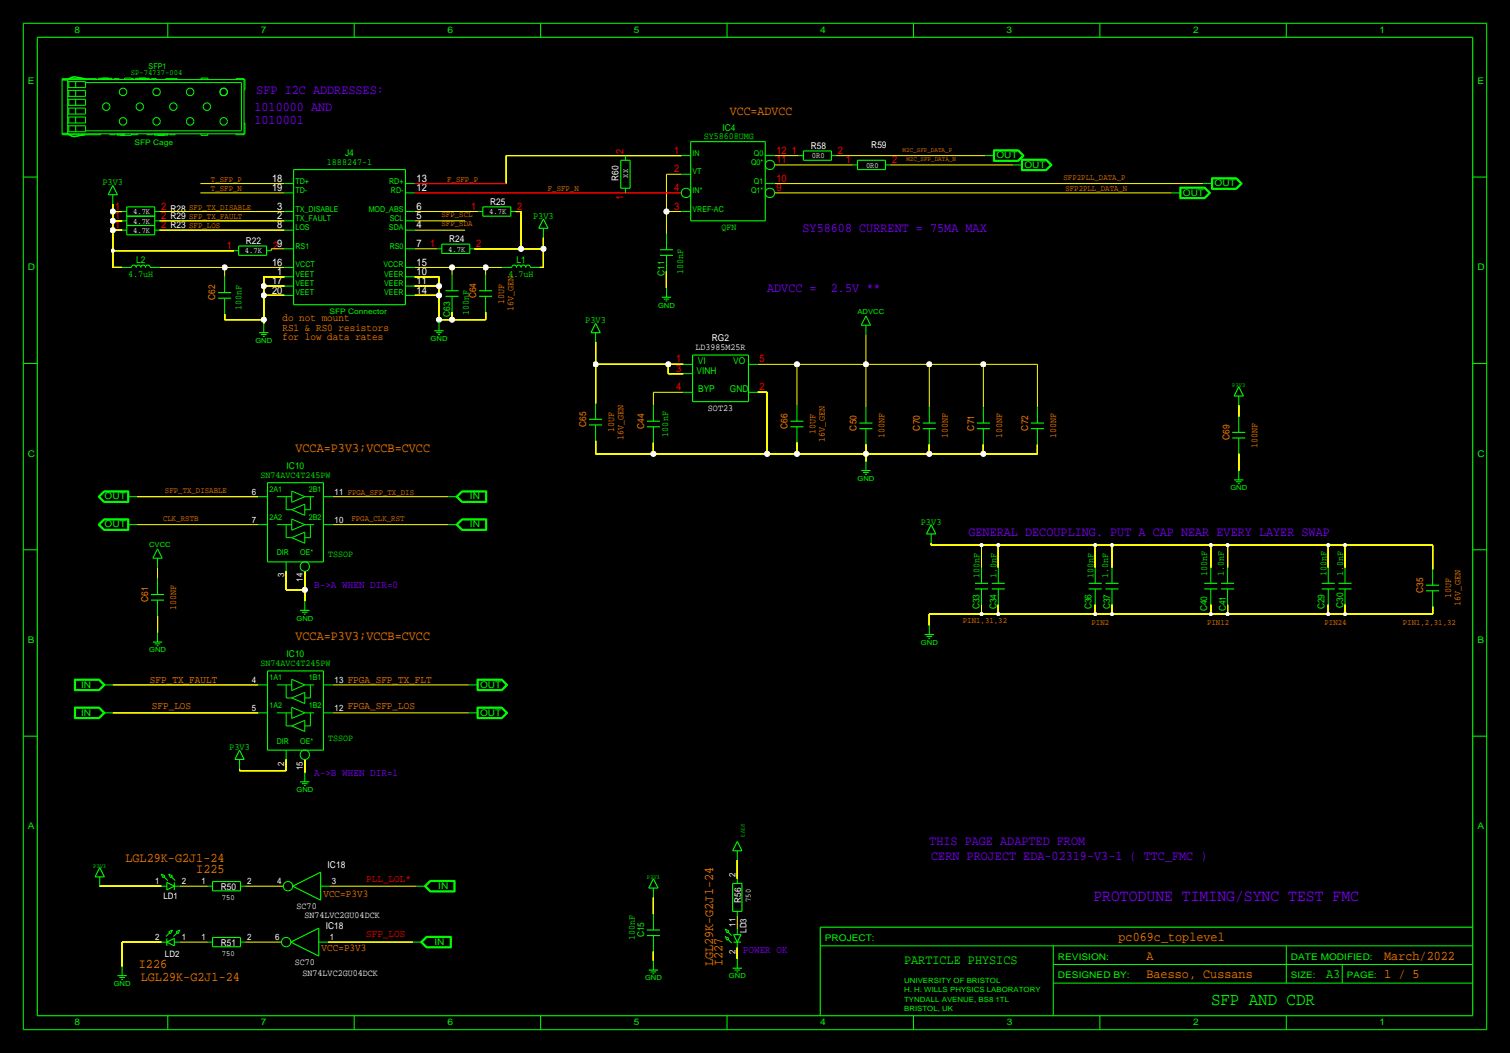
[picture p4: page 1]

1 1 | 2 2 R29 R29 SFP_TX_FAULT SFP_TX_FAULT 2 2 | 4 4 SFP_SDA SFP_SDA R24 R24
1 1 | 2 2 R23 R23 SFP_LOS 8 8 SFP_LOS

17 17 | 11 11
20 20 | 14 14

do not mount
RS1 & RS0 resistors
for low data rates

GENERAL DECOUPLING. PUT A CAP NEAR EVERY LAYER SWAP

THIS PAGE ADAPTED FROM
CERN PROJECT EDA-02319-V3-1 ( TTC_FMC )

PROTODUNE TIMING/SYNC TEST FMC

PARTICLE PHYSICS PARTICLE PHYSICS UNIVERSITY OF BRISTOL H. H. WILLS PHYSICS LABORATORY TYNDALL AVENUE, BS8 1TL BRISTOL, UK | A A REVISION: REVISION: | March/2022 March/2022 DATE MODIFIED: DATE MODIFIED:

Baesso, Cussans DESIGNED BY: | A3 SIZE: | PAGE:

### <-- PG_C2M <-- PRSNT_M2C_L

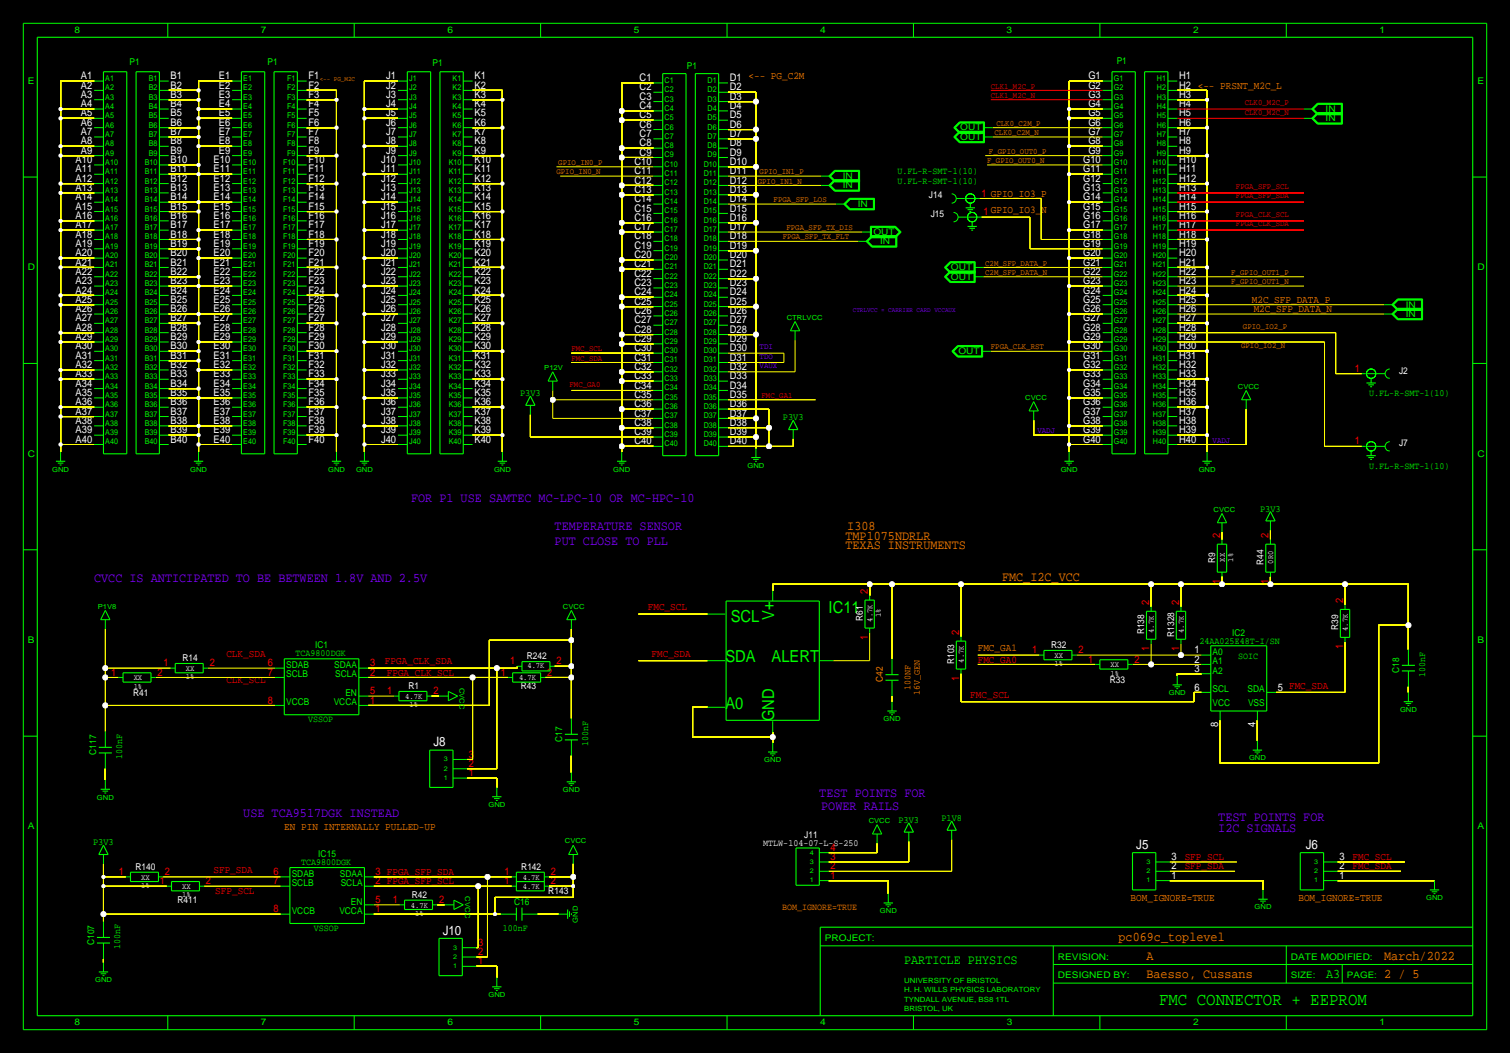
[picture p5: page 2]

CTRLVCC = CARRIER CARD VCCAUX

FOR P1 USE SAMTEC MC-LPC-10 OR MC-HPC-10

TEMPERATURE SENSOR
PUT CLOSE TO PLL

CVCC IS ANTICIPATED TO BE BETWEEN 1.8V AND 2.5V

USE TCA9517DGK INSTEAD
EN PIN INTERNALLY PULLED-UP

FPGA_SFP_SCL | 1 1 | 2 2
R42

## HIGH SPEED D-TYPE FLIP-FLOP (TO REDUCE JITTER ON ENCODED DATA)

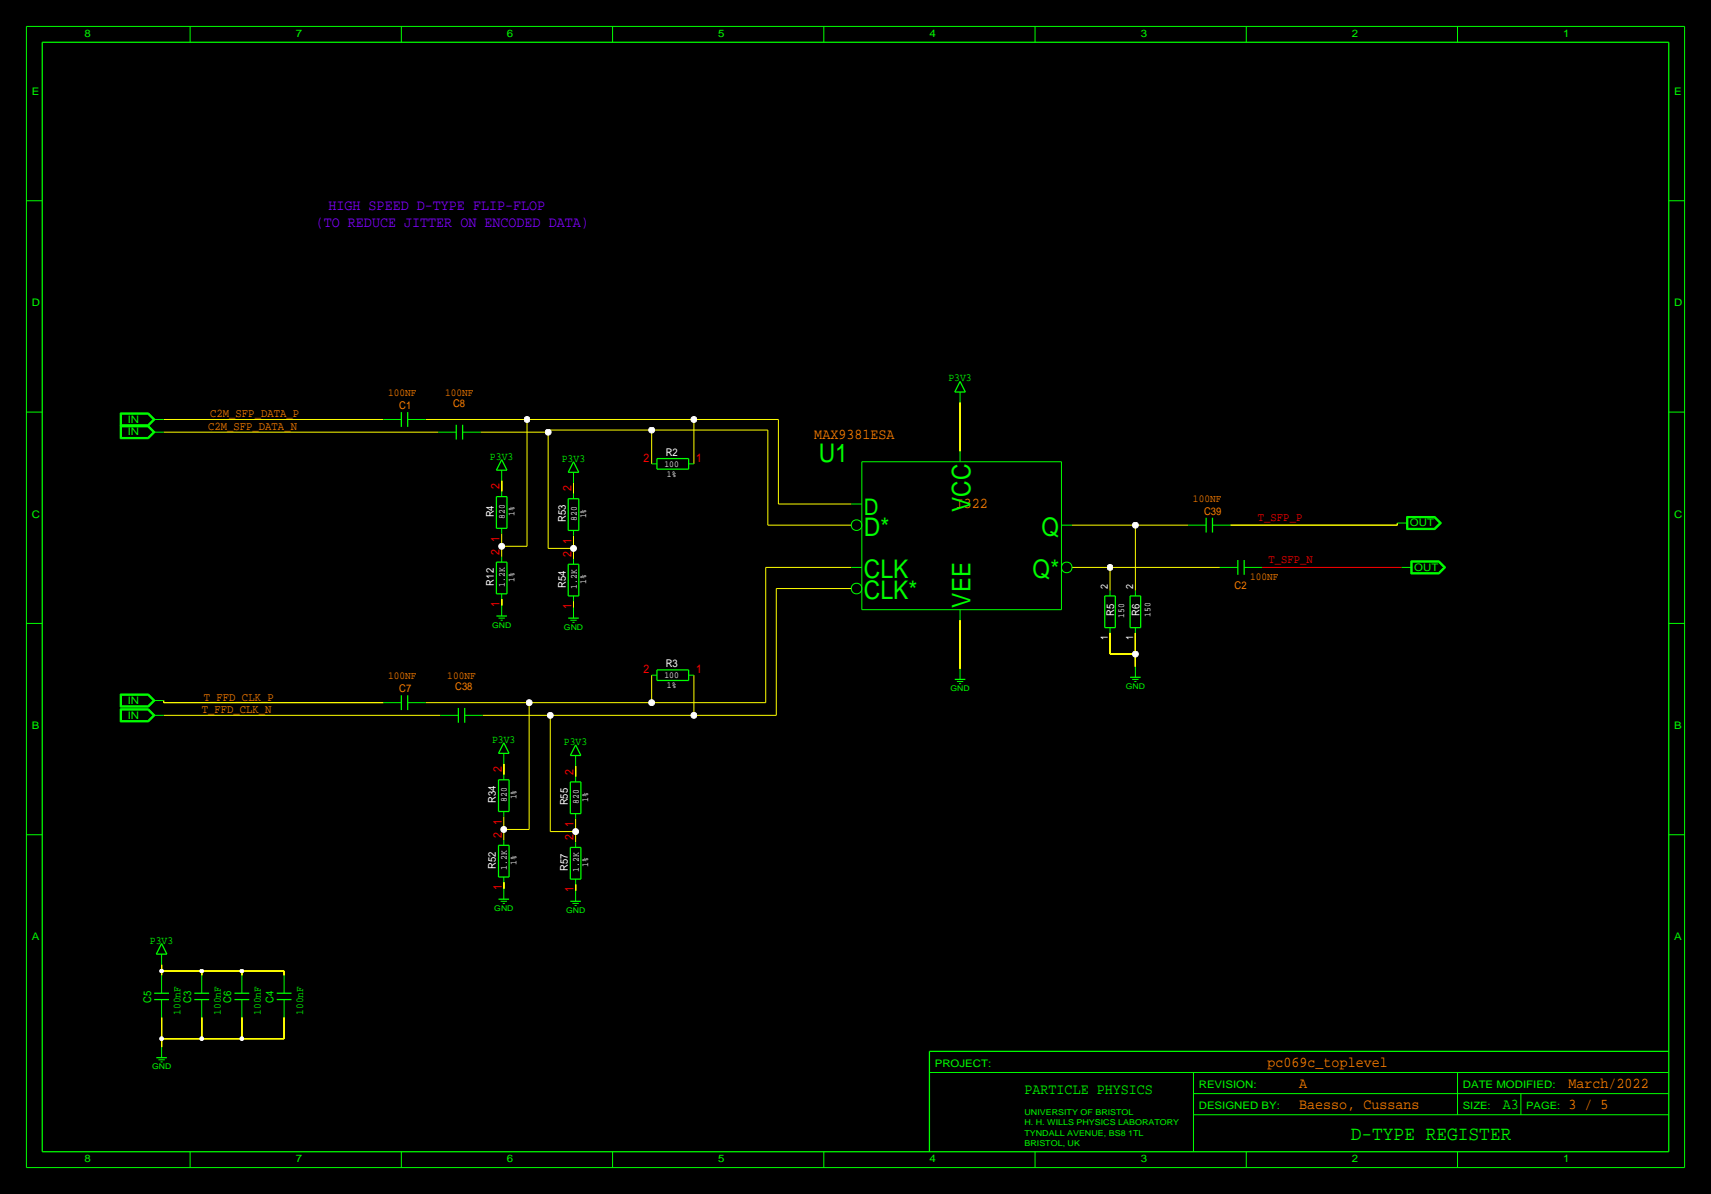
[picture p6: page 3]

HIGH SPEED D-TYPE FLIP-FLOP
(TO REDUCE JITTER ON ENCODED DATA)

## USING I2C USE SI5394A-A-GM

# CLOCK GENERATOR

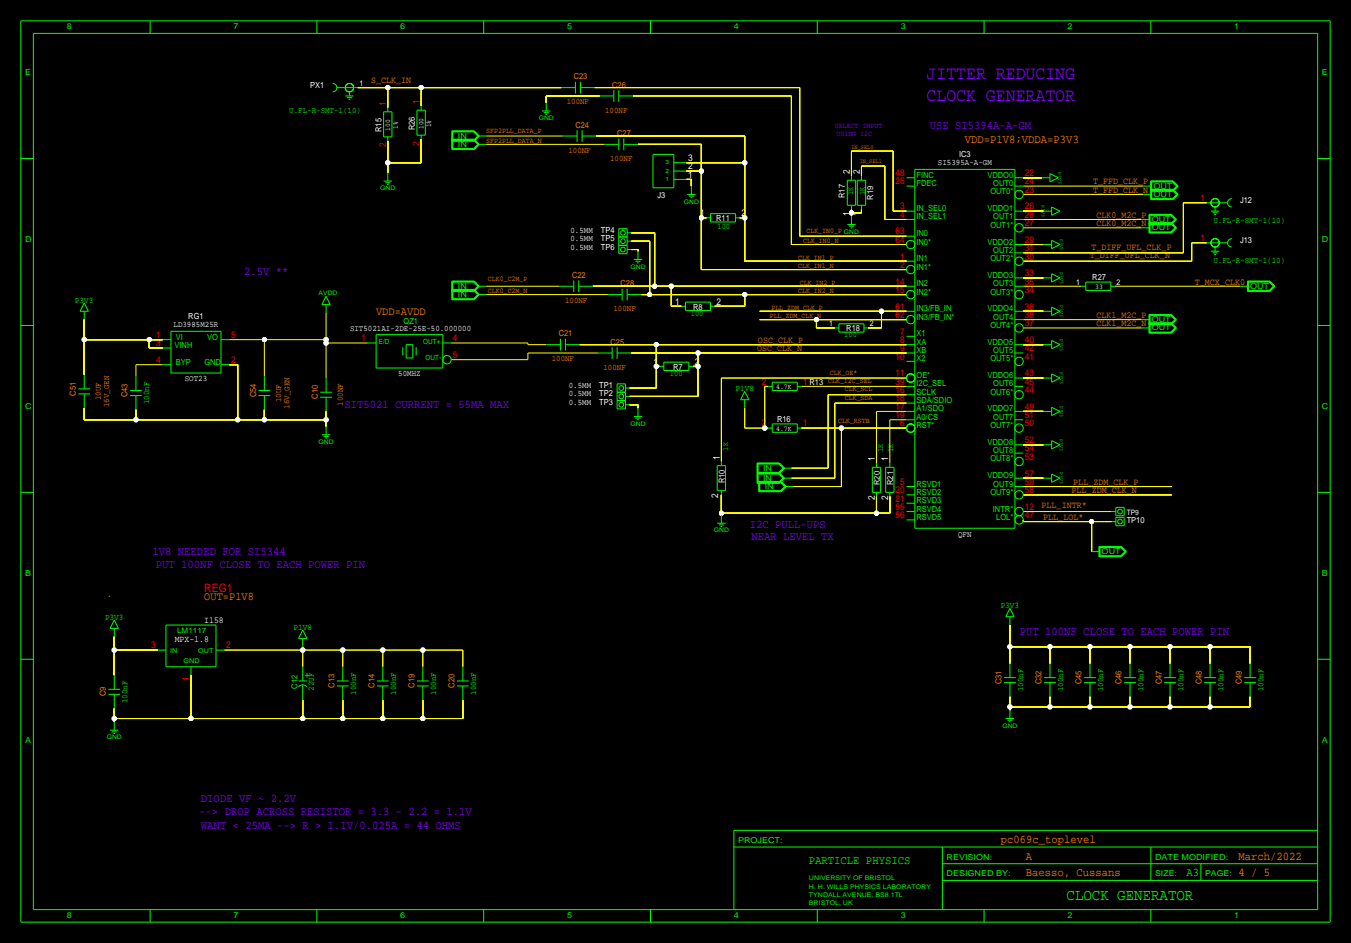
[picture p7: page 4]

OSC_CLK_N OSC_CLK_N 9 9 | 41 41

10 10 11 11 CLK_OE* CLK_OE*

PUT 100NF CLOSE TO EACH POWER PIN

## T_MCX_CLK0

### VCC=P3V3

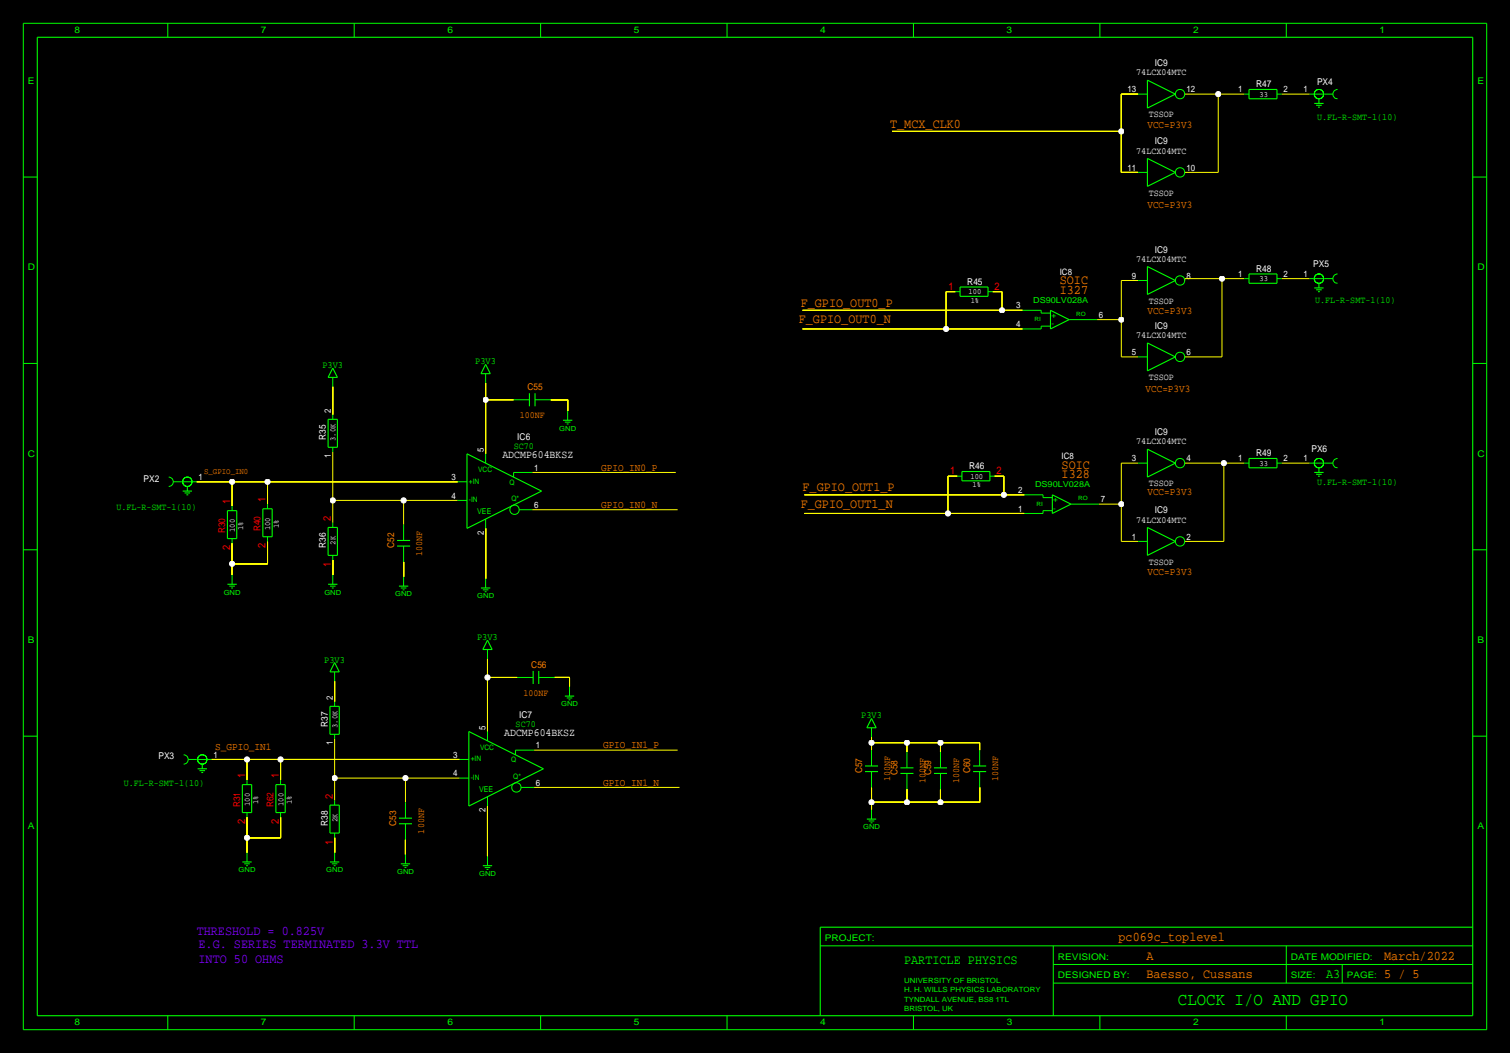
[picture p8: page 5]
