uob-hep-cad/uob-hep-pc069/hardware/Schematics/pc069c_toplevel_printfriendly_5feb25.pdf

## SFP I2C ADDRESSES: 1010000 AND

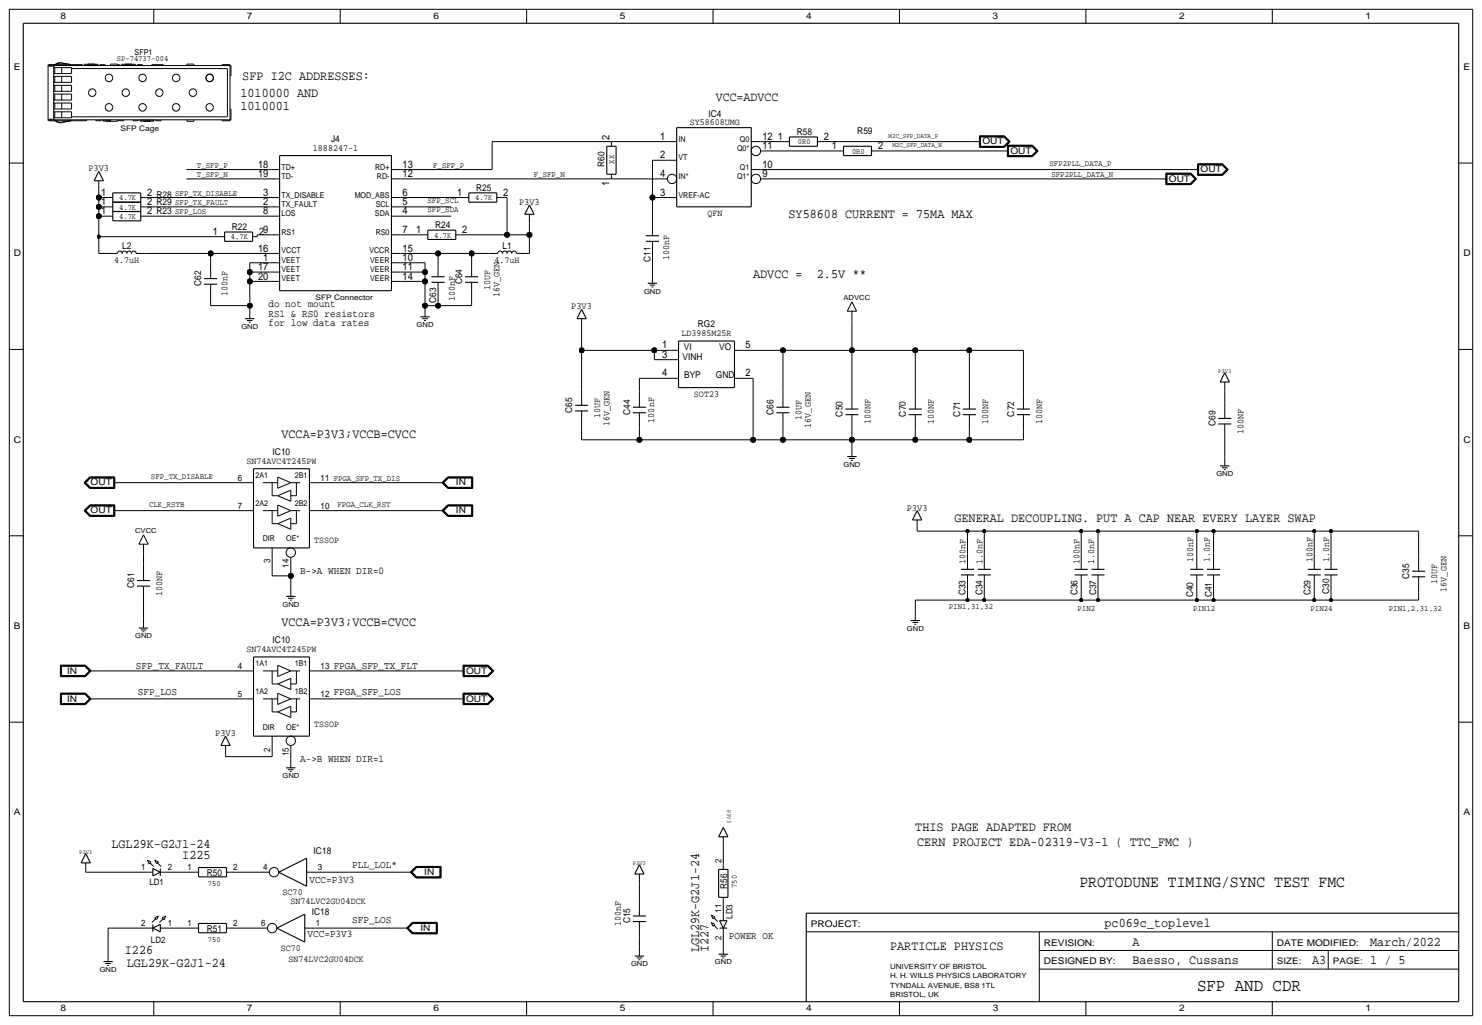
[picture p9: page 1]

1 | 2 R29 SFP_TX_FAULT 2 | 4 SFP_SDA R24
1 | 2 R23 SFP_LOS 8

17 | 11
20 | 14

do not mount
RS1 & RS0 resistors
for low data rates

GENERAL DECOUPLING. PUT A CAP NEAR EVERY LAYER SWAP

THIS PAGE ADAPTED FROM
CERN PROJECT EDA-02319-V3-1 ( TTC_FMC )

PROTODUNE TIMING/SYNC TEST FMC

PARTICLE PHYSICS UNIVERSITY OF BRISTOL H. H. WILLS PHYSICS LABORATORY TYNDALL AVENUE, BS8 1TL BRISTOL, UK | A REVISION: | March/2022 DATE MODIFIED:

Baesso, Cussans DESIGNED BY: | A3 SIZE: | PAGE:

### <-- PG_C2M <-- PRSNT_M2C_L

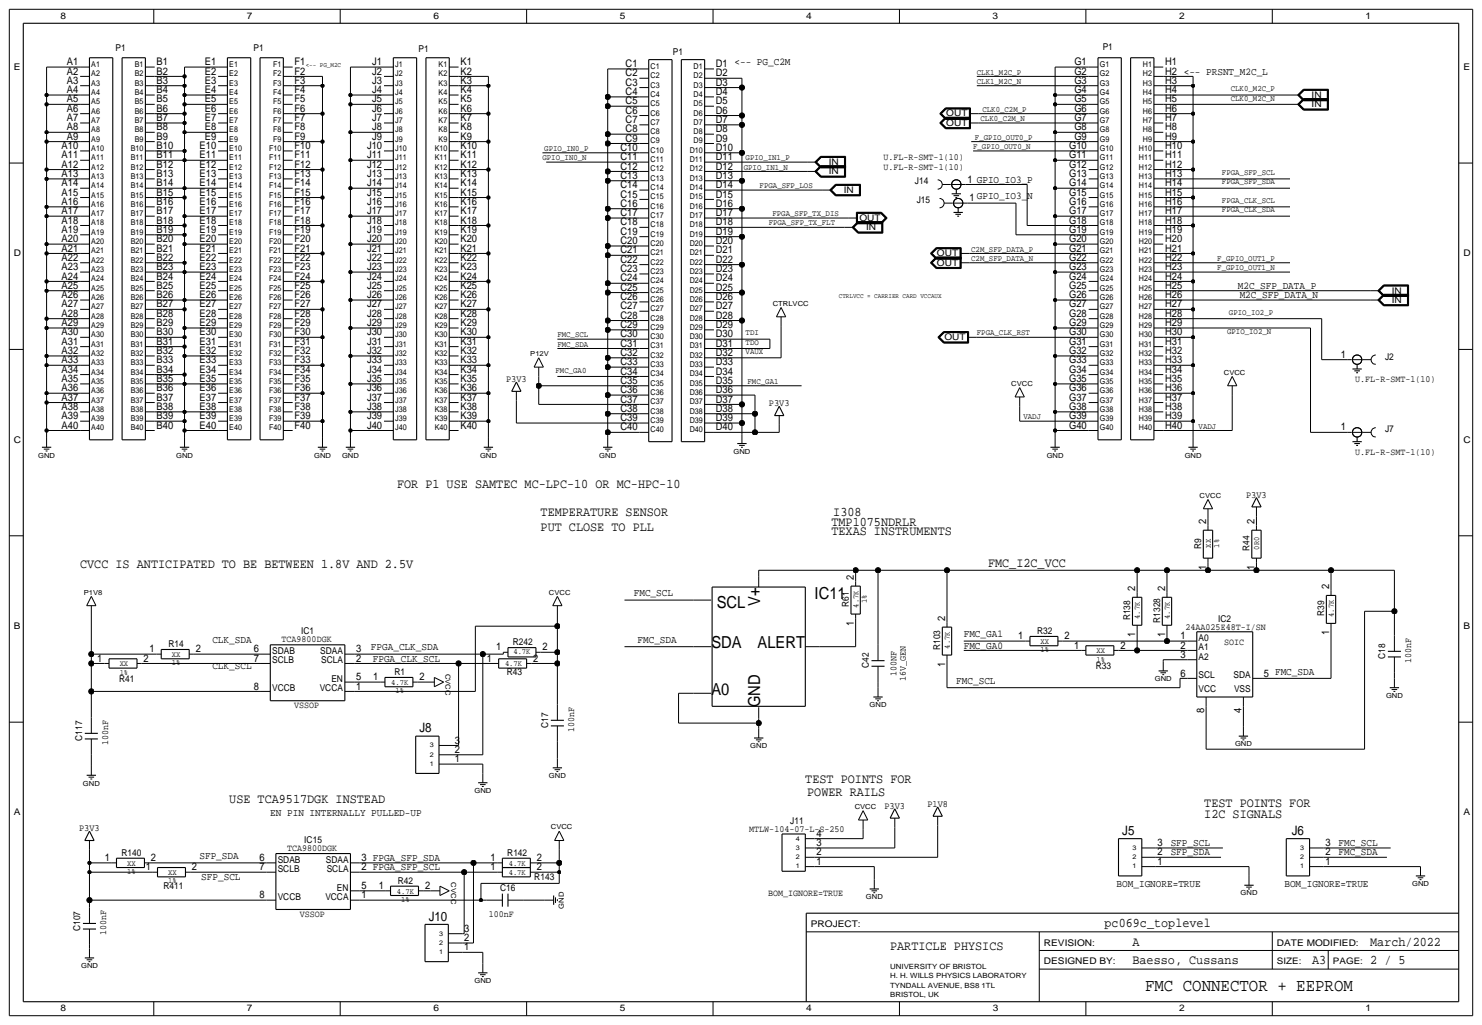
[picture p10: page 2]

CTRLVCC = CARRIER CARD VCCAUX

FOR P1 USE SAMTEC MC-LPC-10 OR MC-HPC-10

TEMPERATURE SENSOR
PUT CLOSE TO PLL

CVCC IS ANTICIPATED TO BE BETWEEN 1.8V AND 2.5V

USE TCA9517DGK INSTEAD
EN PIN INTERNALLY PULLED-UP

FPGA_SFP_SCL | 1 | 2
R42

## HIGH SPEED D-TYPE FLIP-FLOP (TO REDUCE JITTER ON ENCODED DATA)

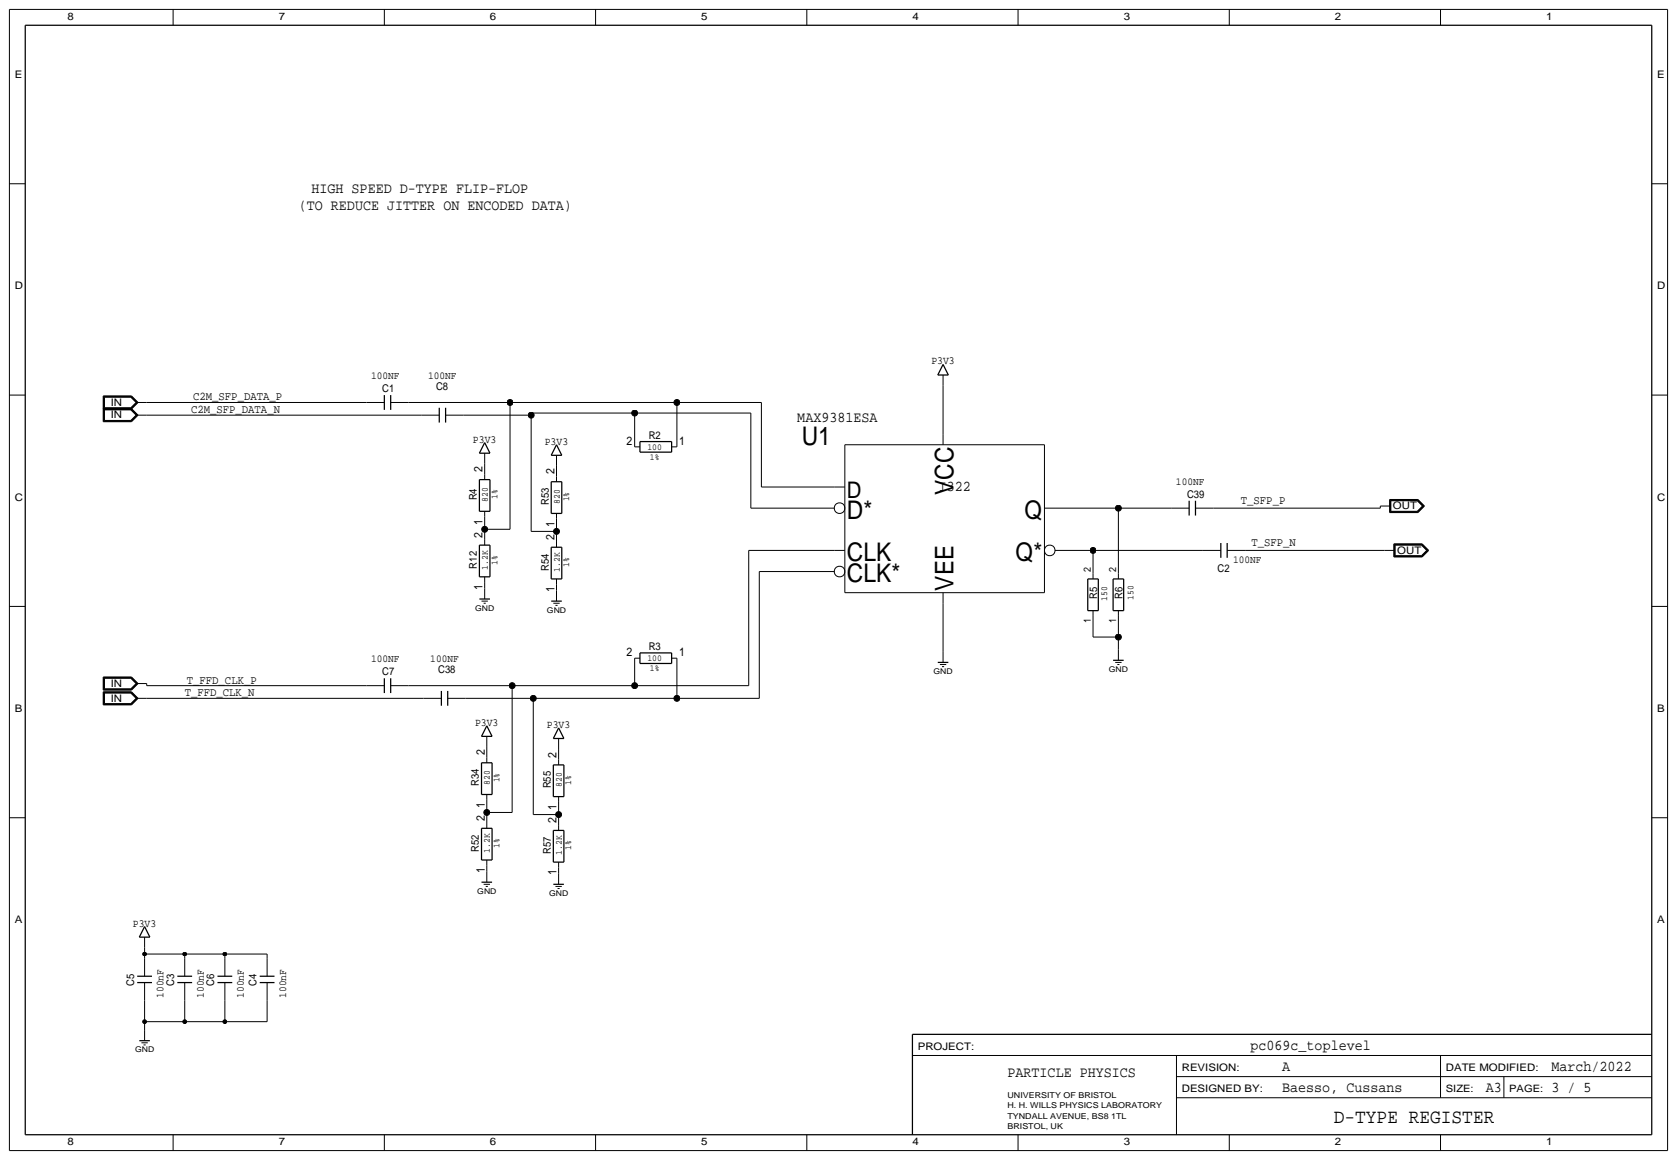
[picture p11: page 3]

## USING I2C USE SI5394A-A-GM

# CLOCK GENERATOR

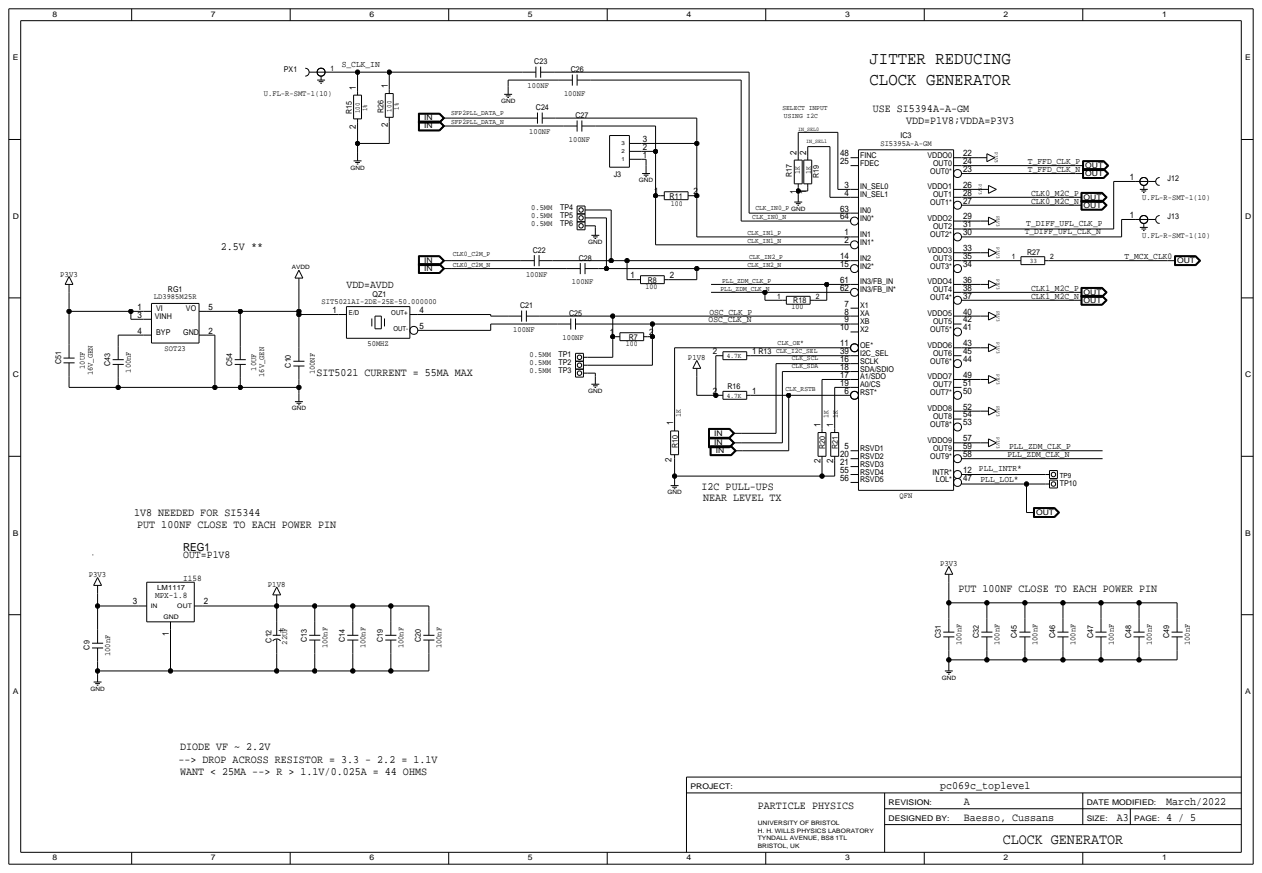
[picture p12: page 4]

OSC_CLK_N 9 | 41

10 11 CLK_OE*

PUT 100NF CLOSE TO EACH POWER PIN

## T_MCX_CLK0

### VCC=P3V3

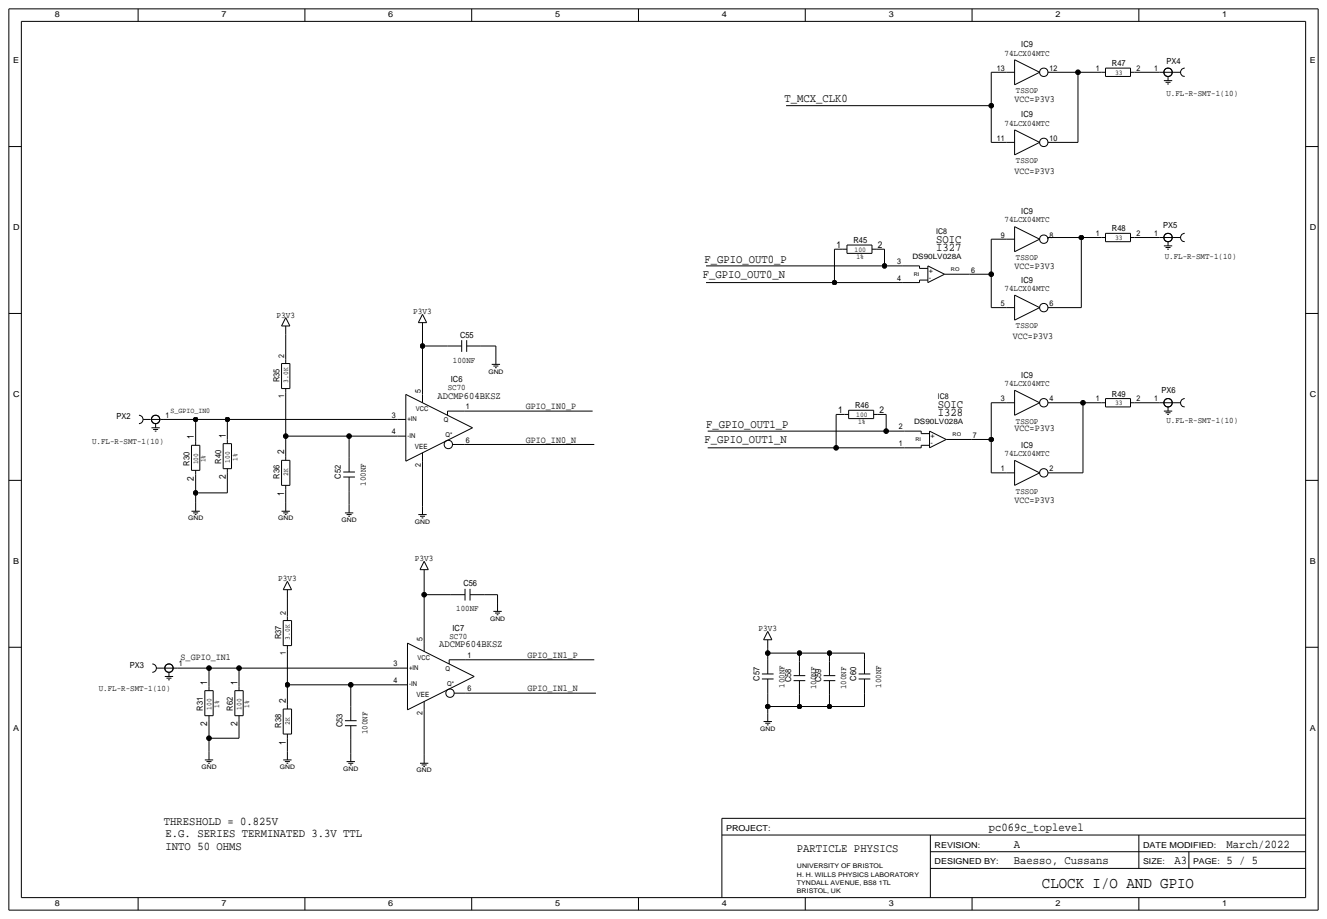
[picture p13: page 5]
