uob-hep-cad/uob-hep-pc069/(commit log)

2023-09-08 Initial commit of Cadence files (copied from pc068a)
    [446611011.0001.ipt, 446611011.0002.ipt, 446611011.ipt, 459704305.0001.ipt, 459704305.0003.ipt, 459704305.ipt, 471510002.ipt, 747370004.0001.ipt]
2023-09-08 Deleting files left over from import from pc053
    [446611011.0001.ipt, 446611011.0002.ipt, 446611011.ipt, 459704305.0001.ipt, 459704305.0003.ipt, 459704305.ipt, 471510002.ipt, 747370004.0001.ipt]
2023-09-08 Commit changes to schematic and first export of *.brd file
    [page4.csv]
2023-09-08 Replaced si53x4 --> si5395 and D-FF
    [page1.csv, page2.csv, page3.csv, page4.csv, page6.csv]
2023-09-08 Removed HDMI connector. Added some visual sugar (offpage indicators)
    [page1.csv, page2.csv, page3.csv, page4.csv, page6.csv]
2023-09-08 Printed out schematics
    [page1.csv, page2.csv, page3.csv, page4.csv, page5.csv]
2023-09-08 Adding most recent layout
    [pc069a_1perline_bom.csv, pc069a_summary_bom.csv]
2023-09-08 Updating PDF copy of schematics
2023-09-08 Simplified U/FL clock input. Added filter for TCXO power. Continued with layout
    [page4.csv, page5.csv]
2023-09-08 Finished layout. Couple of cosmetic changes to schematic. Generated manufacturing artwork ( Gerber, not ODB++ )
    [art_param.txt, nc_param.txt, page1.csv, pc069a_1perline_bom.csv, pc069a_bom.xlsx, pc069a_summary_bom.csv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]
2023-09-08 CHecking in final changes to pc069a . Including export of Allegro parts
    [c0402.psm, c0603.psm, c0805.psm, c3528pol.psm, hirose_u-fl-r-smt-1_10.psm, indc3225x220n.psm, ledc1708x65n.psm, molex_74737004.psm]
2023-09-08 Committing bug-fixed files (termination fix)
    [446611011.0001.ipt, 459704305.0001.ipt, 459704305.ipt, 471510002.ipt, 747370004.0001.ipt, 747370004.ipt, A3F1807F-1856-4851-85FF-7D796C268A47.0001.ipt, A3F1807F-1856-4851-85FF-7D796C268A47.ipt]
2023-09-08 Committing bug-fixed files part2
    [art_param.txt, nc_param.txt, page3.csv, page5.csv]
2023-09-11 Adding artwork files for pc069b
    [art_param.txt, nc_param.txt, pc069b_1perline_bom.csv, pc069b_summary_bom.csv, pc069b_summary_bom.xlsx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]
2024-12-04 Copied pc069b to pc069c , swapped I2C level translators to TCA9800 ( can operate down to 1.8V ). Exported to PCB, did layout. Tried to produce artwork - get errors ( layer polarity doesn't match cros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
    [446611011.0001.ipt, 459704305.0001.ipt, 459704305.ipt, 471510002.ipt, 747370004.0001.ipt, 747370004.ipt, A3F1807F-1856-4851-85FF-7D796C268A47.0001.ipt, A3F1807F-1856-4851-85FF-7D796C268A47.ipt]
2025-01-29 Added regulators to supply 2.5V from 3.3V rather than relying on CVVC (VCCIO) being 2.5V. Swapped some capacitor to reduce number of items in BoM. First pass at place and route of PCB
    [Si5344-RevB-Regmap.csv, SingleWidthFMC.stp, StepOutConfiguration.txt, art_param.txt, case.cfg, cases.cfg, expand.cfg, fmc_connections.csv]
2025-01-31 Tidying up - deleting pc069{a,b} files from pc069c directorty
    [pc069a-1-6.drl, pc069b_15-1-6.drl]
2025-02-04 Went through schematic with Magnus. Spotted that FMC_{SCL,SDA} are probably 3.3V signals. So, added zero ohm link to connect to 3.3V for TMP1075 and 24AA.... with option to connect to CVCC
    [art_param.txt, nc_param.txt, page1.csv, page2.csv, page4.csv, pc069c_summary_bom.csv, pc069c_summary_bom.xlsx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]
2025-02-05 Replaced si5345 with local copy edited to si5395 (lacks the extra pins of the real si5395 but at least will show up in BoM correctly... Exported to PCB and first pass layout
    [page2.csv, page4.csv, page5.csv]
2025-02-06 Sent pc069c_25-manufacturing-artwork-2025-02-06.zip for manufacture
    [art_param.txt, nc_param.txt, page2.csv, pc069c_summary_bom.csv, pc069c_summary_bom_mouser.xlsx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]
